h0t5tuff/Stratospheric-Research-Balloon/GP030997_Moment(6).jpg

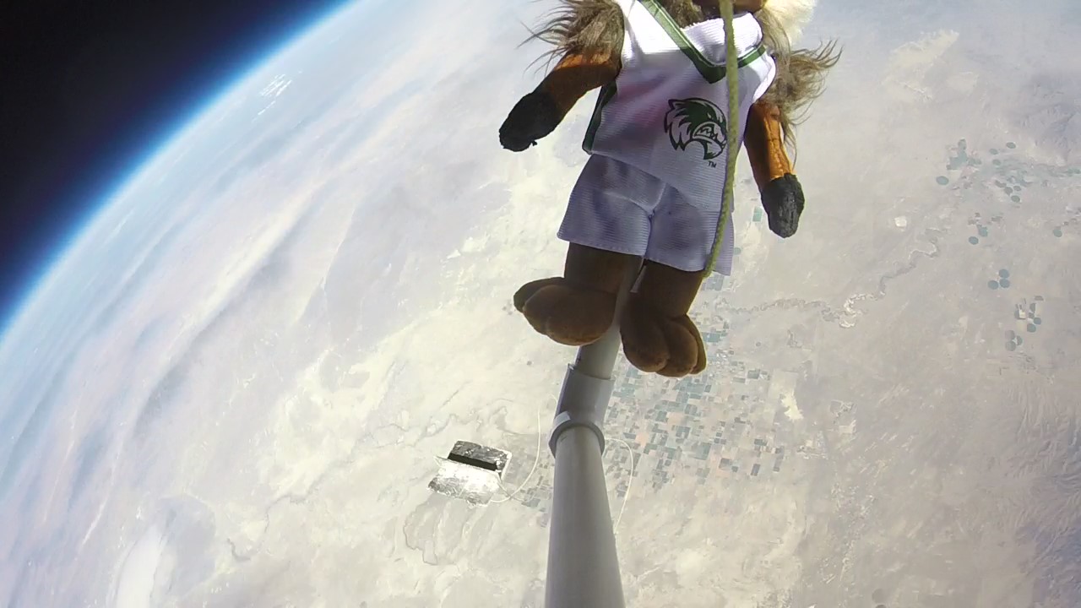
GP030997_Moment(6).jpg
