h0t5tuff/Stratospheric-Research-Balloon/Flight Predictor (Burst Calc).png

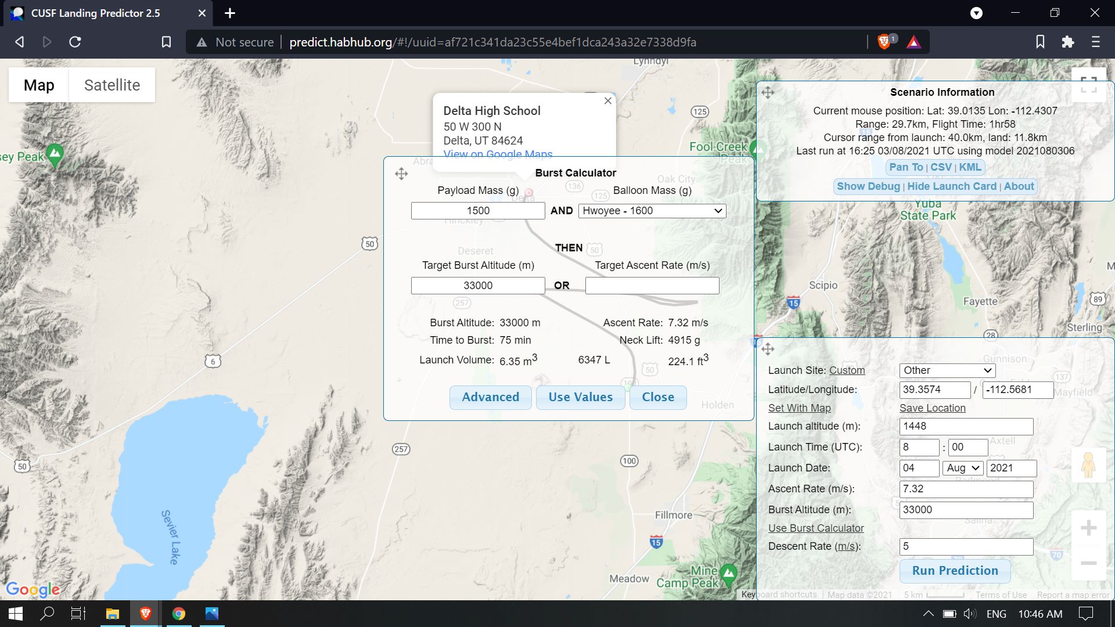
Flight Predictor (Burst Calc).png
