h0t5tuff/Stratospheric-Research-Balloon/81TI5b4ppGL._SL1200_.jpg

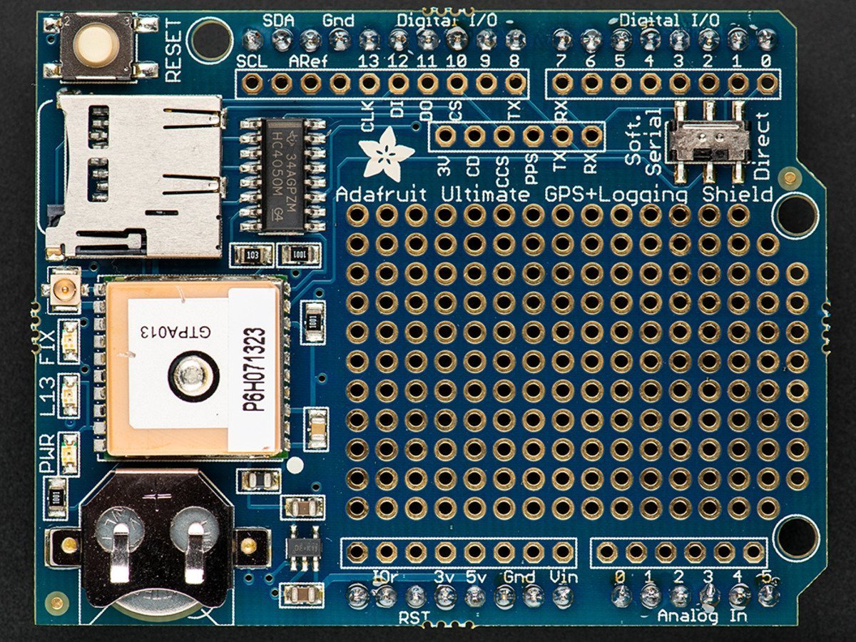
81TI5b4ppGL._SL1200_.jpg
