h0t5tuff/Stratospheric-Research-Balloon/1231-00.jpg

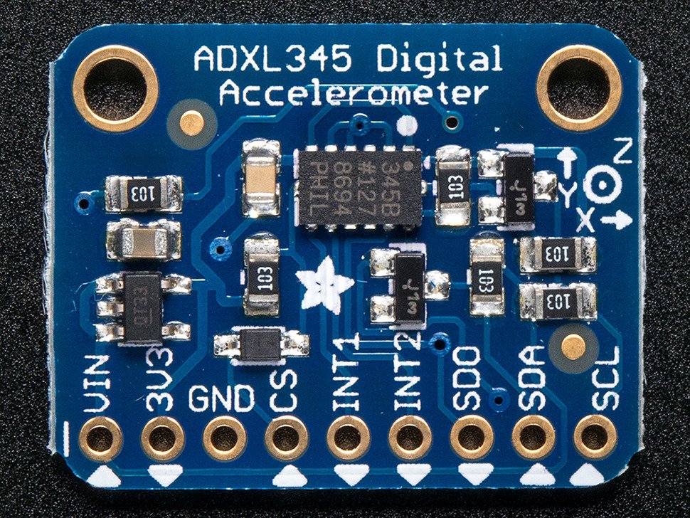
1231-00.jpg
