h0t5tuff/Stratospheric-Research-Balloon/Final_burst_calc.png

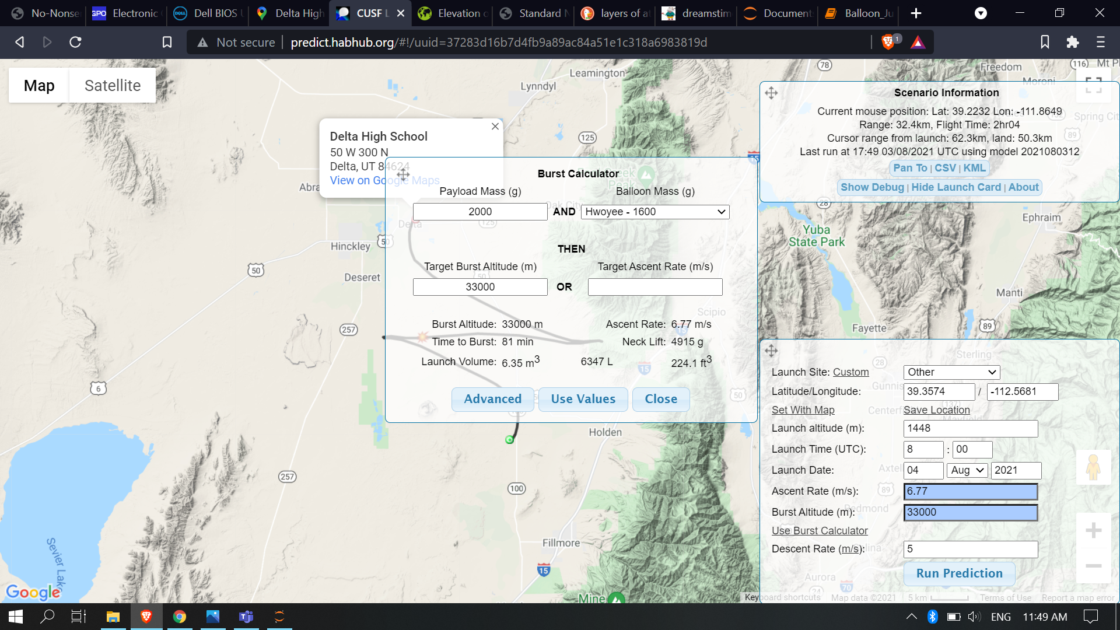
Final_burst_calc.png
