h0t5tuff/Stratospheric-Research-Balloon/Final_flight_path.png

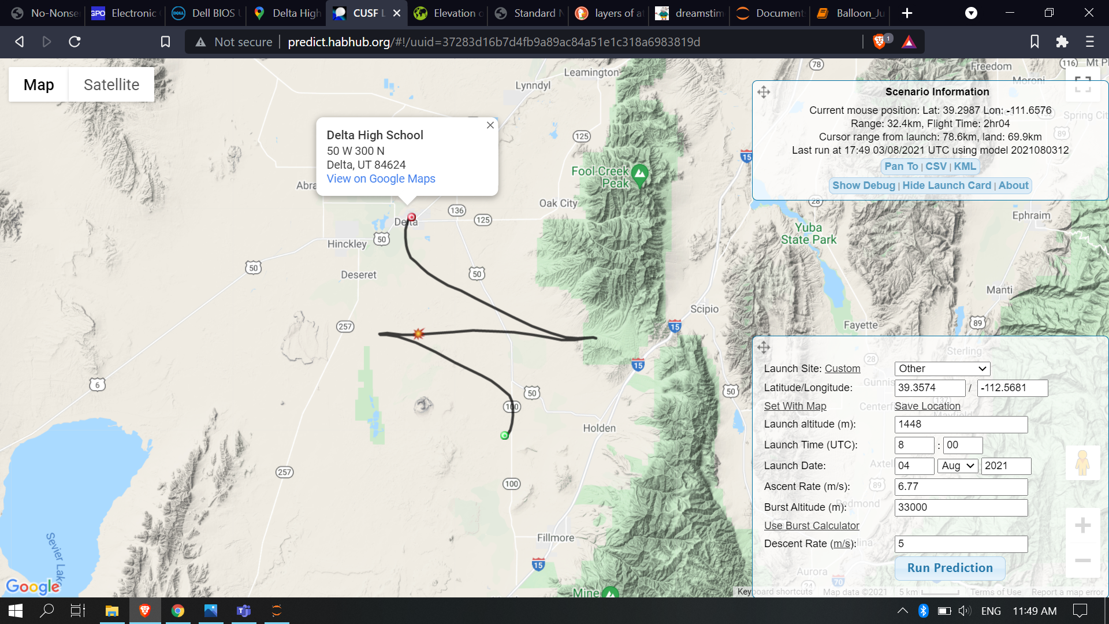
Final_flight_path.png
