h0t5tuff/Stratospheric-Research-Balloon/Flight Predictor.png

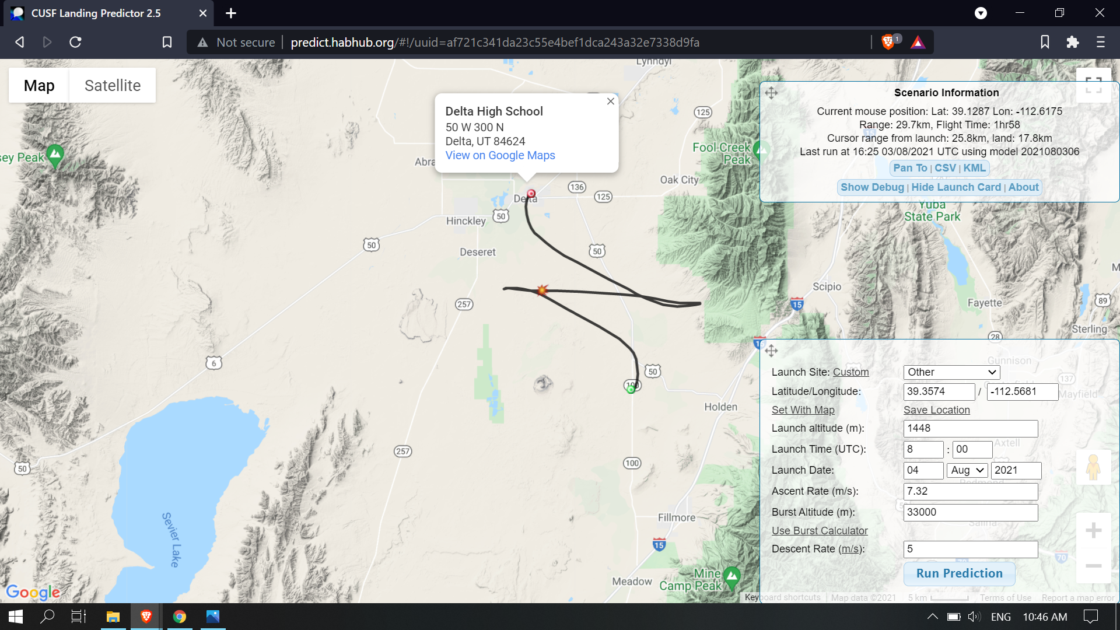
Flight Predictor.png
