h0t5tuff/Stratospheric-Research-Balloon/GOPR0997_Moment(4).jpg

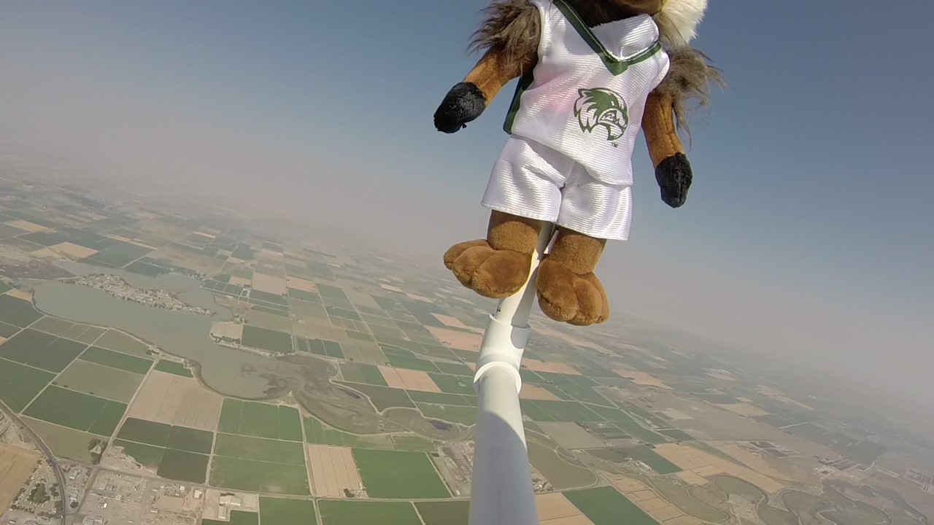
GOPR0997_Moment(4).jpg
