h0t5tuff/Stratospheric-Research-Balloon/GP030997_Moment(14).jpg

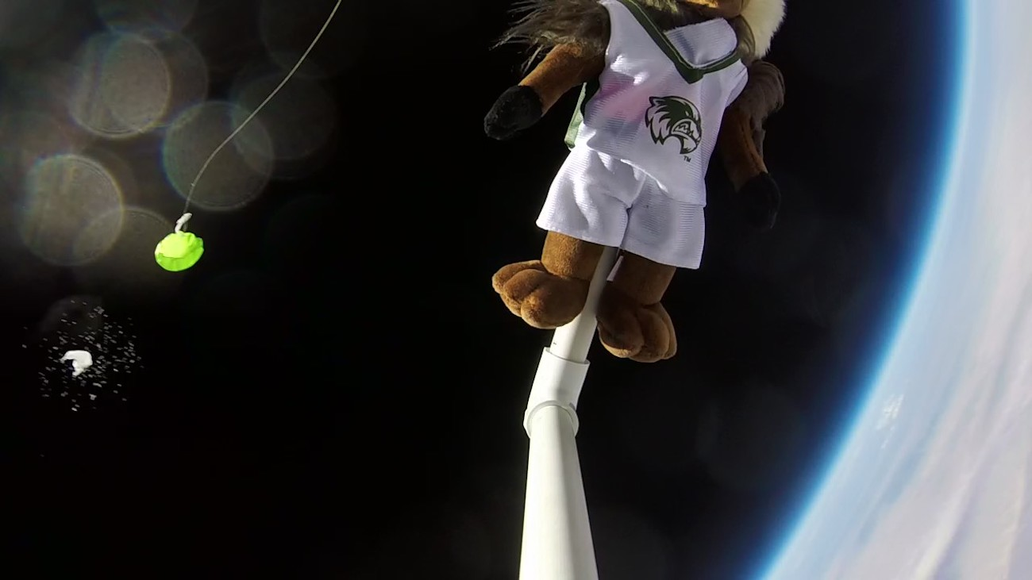
GP030997_Moment(14).jpg
