h0t5tuff/Stratospheric-Research-Balloon/GP030997_Moment.jpg

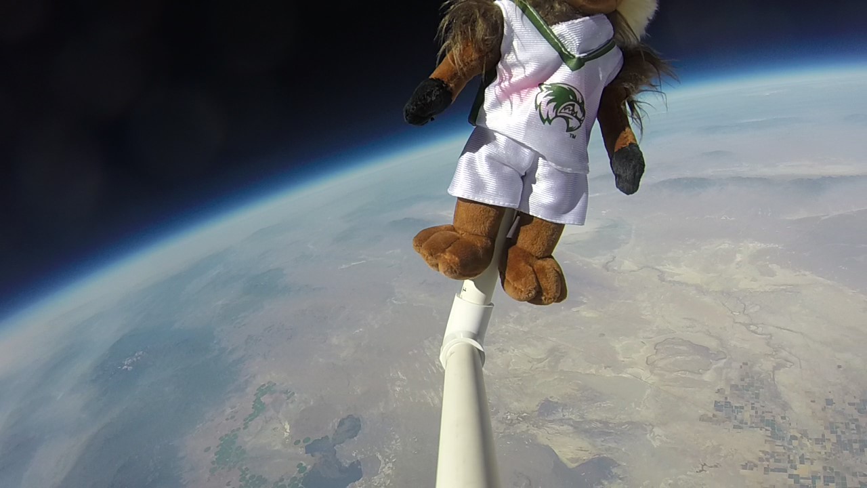
GP030997_Moment.jpg
