h0t5tuff/Stratospheric-Research-Balloon/Magnetic_field/lab8_figure2.png

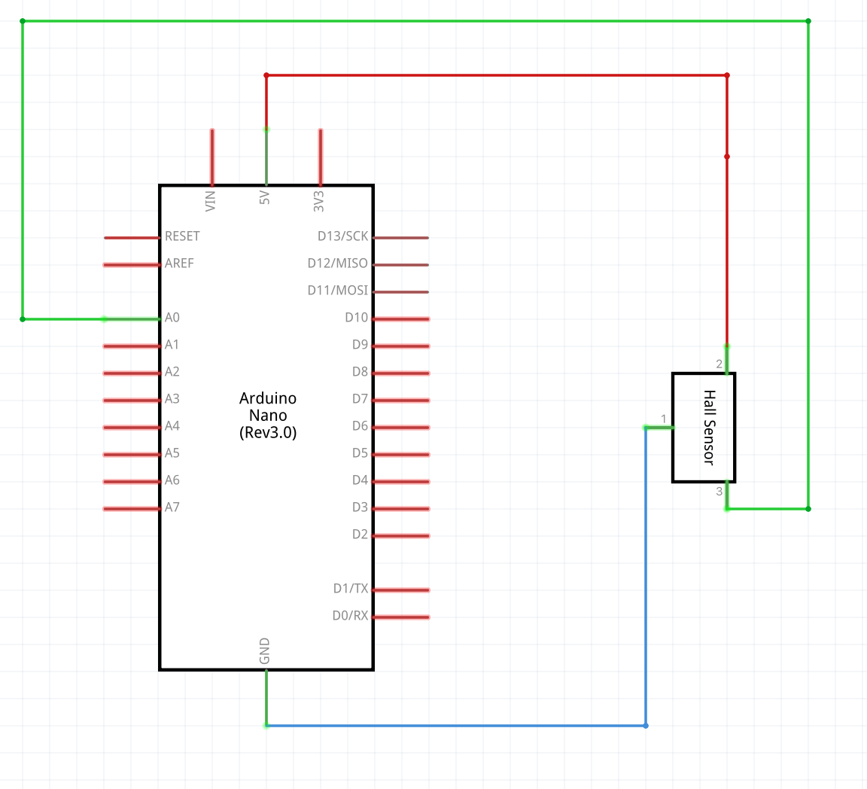
Magnetic_field/lab8_figure2.png
