h0t5tuff/Stratospheric-Research-Balloon/Magnetic_field/lab8_figure5.png

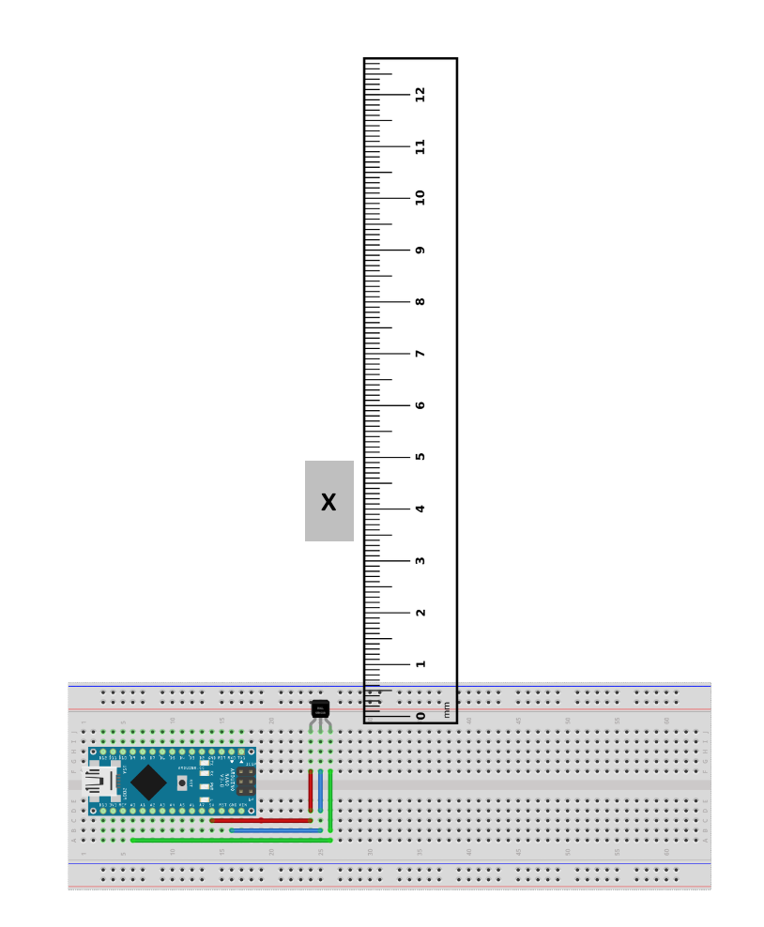
Magnetic_field/lab8_figure5.png
