h0t5tuff/Stratospheric-Research-Balloon/Screen Shot 2021-12-03 at 13.14.21.png

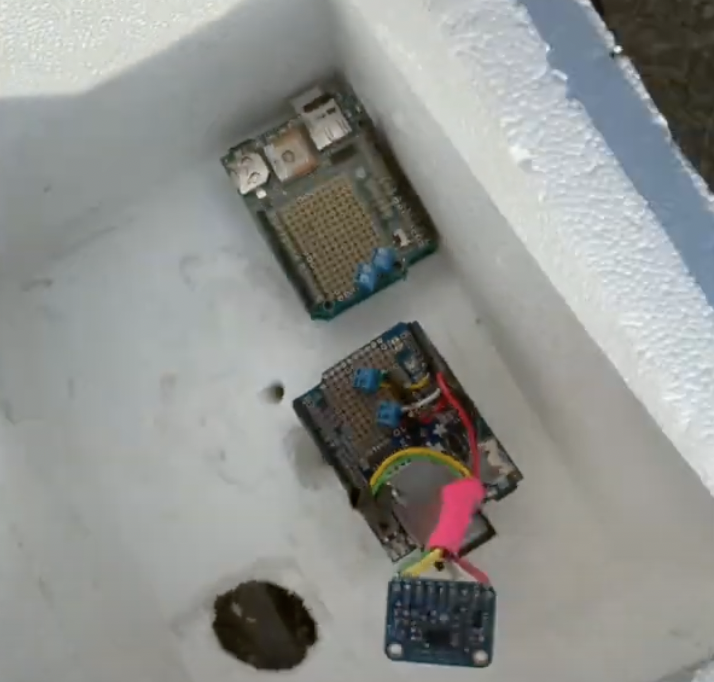
Screen Shot 2021-12-03 at 13.14.21.png
