h0t5tuff/Stratospheric-Research-Balloon/Screenshot from 2021-07-30 08-01-32.png

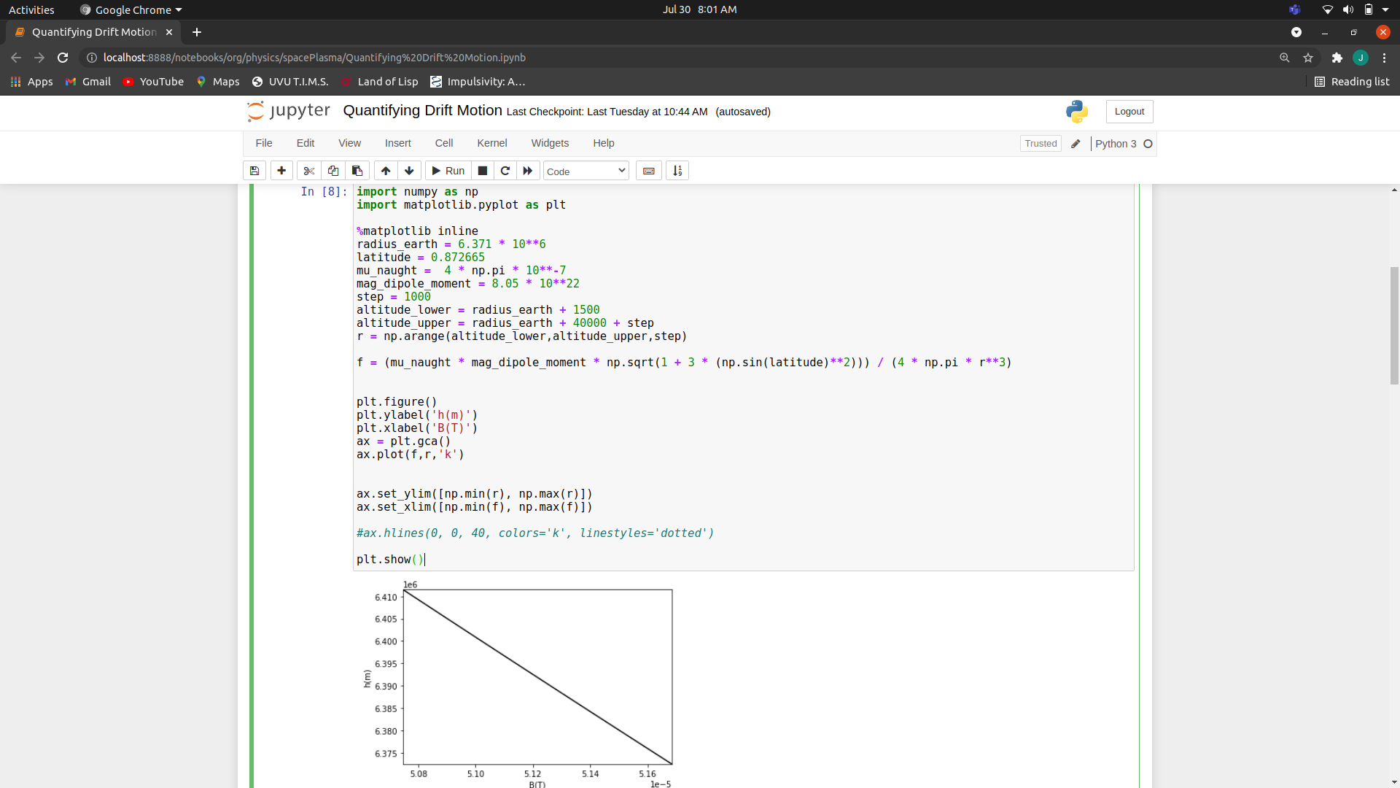
Screenshot from 2021-07-30 08-01-32.png
