h0t5tuff/Stratospheric-Research-Balloon/(list of files, drawings)

Other design files:
Magnetic_field/hall sensor.fzz
