h0t5tuff/Stratospheric-Research-Balloon/PXL_20210804_152345540.jpg

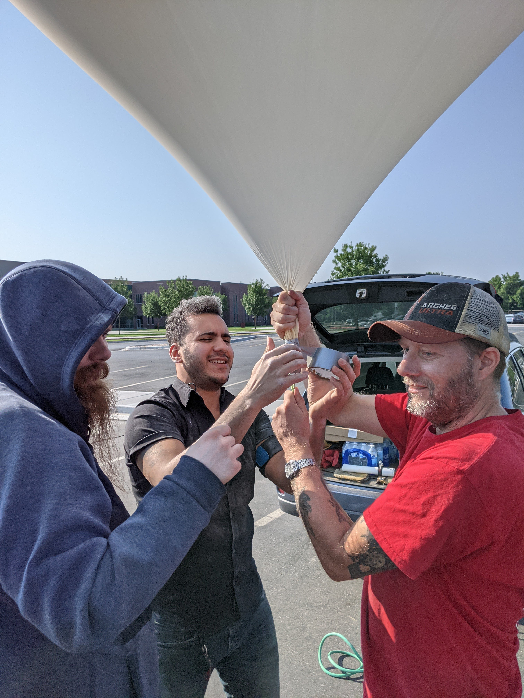
PXL_20210804_152345540.jpg
